M-Mrk/DrumTime/img/DrumTime_1st_sketch.png

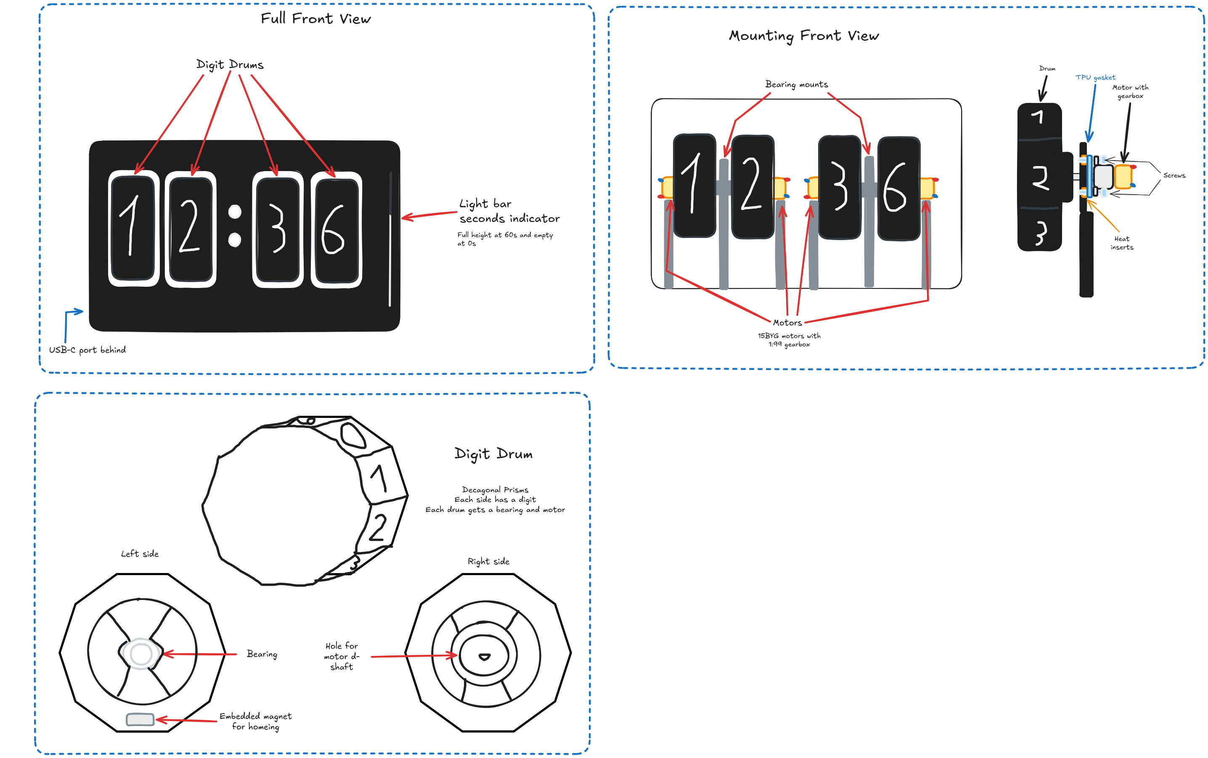
img/DrumTime_1st_sketch.png
