M-Mrk/DrumTime/cad/pcb.step

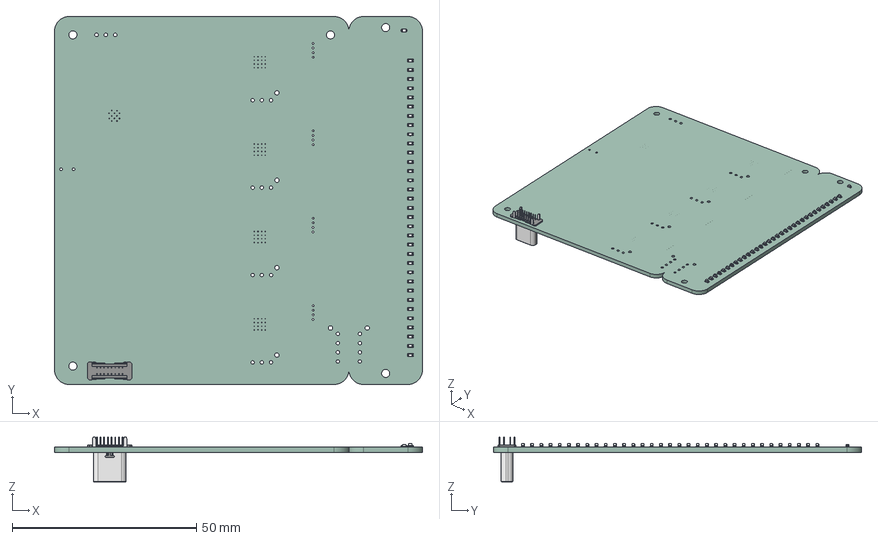
[picture p2: CAD file, 2026-10-08]
cad/pcb.step
100.0 x 100.0 x 12.1 mm
LED0603-R-RD_WHITE x 33
LED-ARRAY-SMD_4P-L1.6-W0.8-BL-FD
零件4
DrumTime_PCB
