M-Mrk/DrumTime/(list of files, drawings)

Other design files:
pcb/temp-freerouting.dsn
