M-Mrk/DrumTime/pcb/DrumTime.kicad_pcb

## KiCad design pcb/DrumTime.kicad_pcb (2026-10-08)

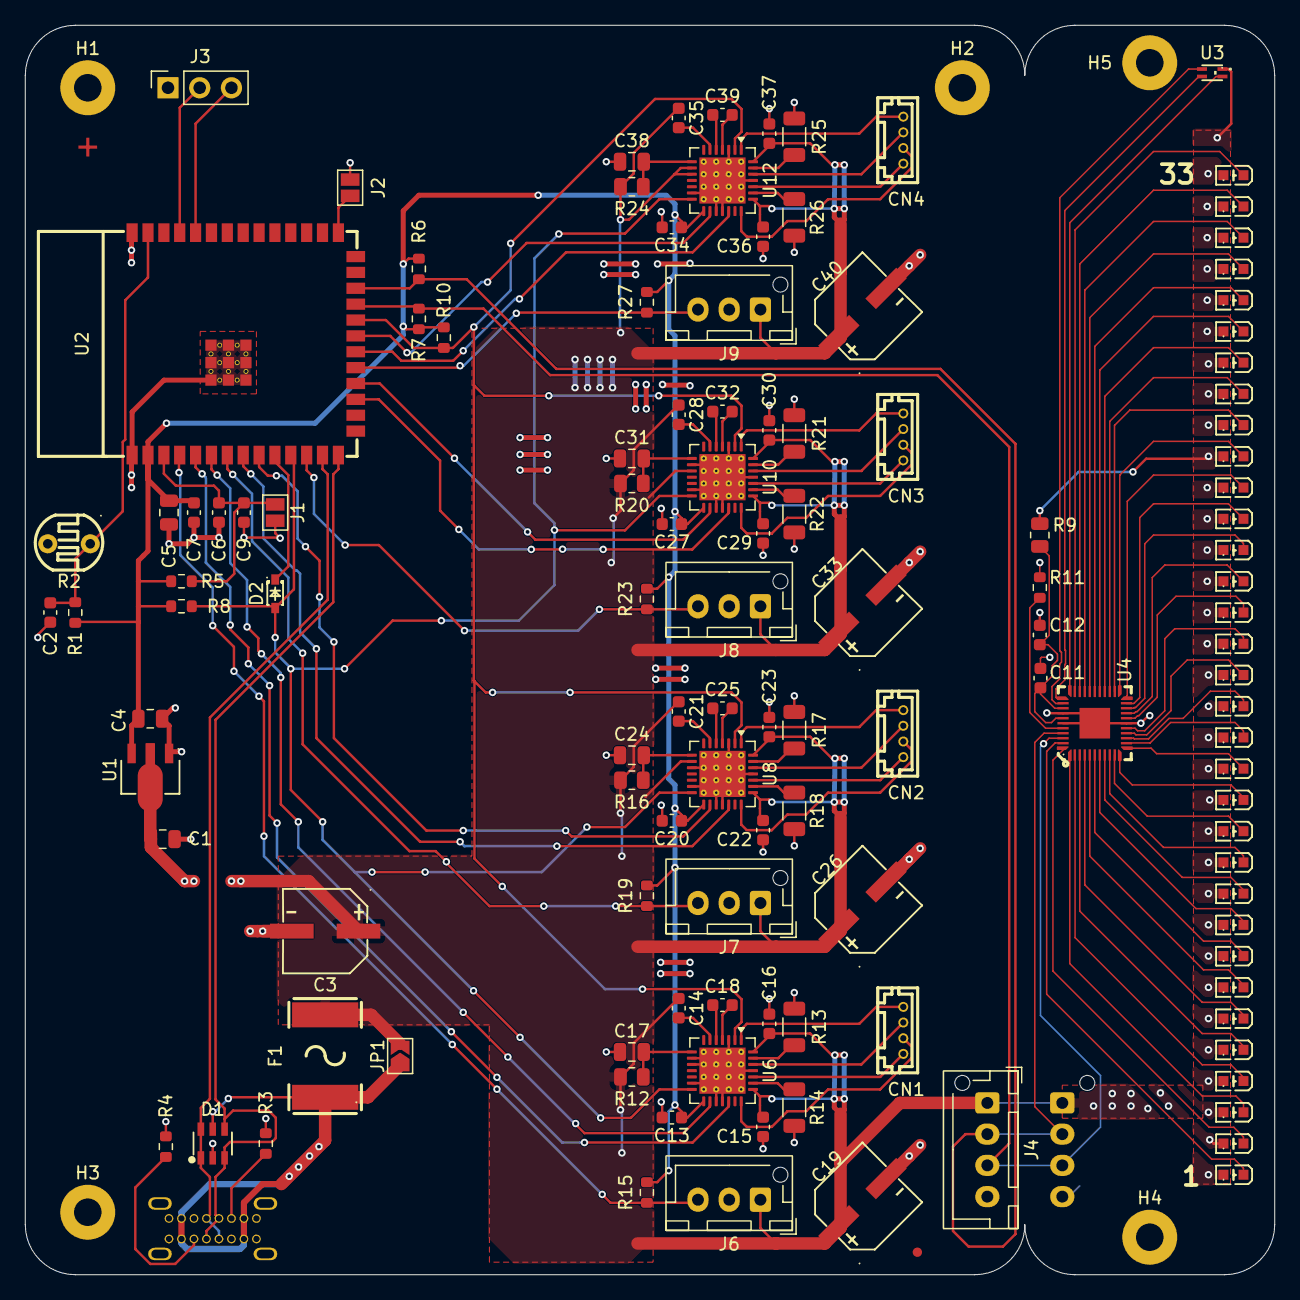
[picture p3: board DrumTime.kicad_pcb from above]

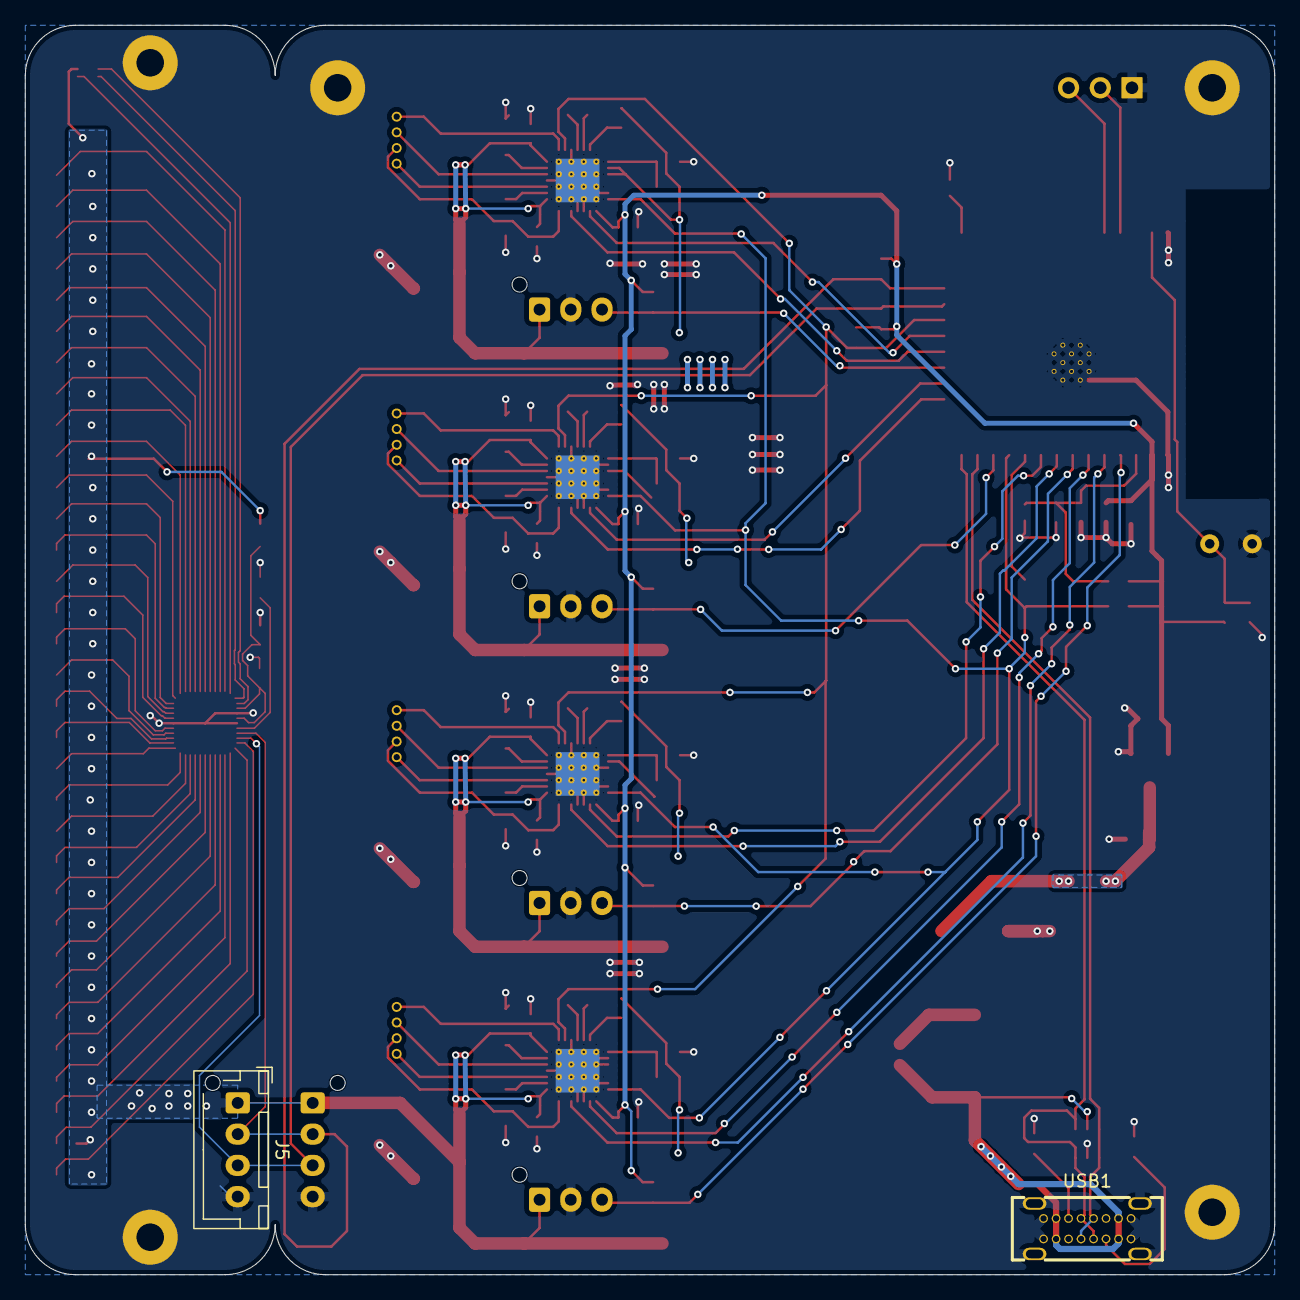
[picture p4: board DrumTime.kicad_pcb from below]

Board: 2 copper layers, 100.0 x 100.0 mm, 131 parts (2 on the bottom side), 108 nets.

Parts:
C1, C4, C17, C24, C31, C38: 10uF; C_0805_2012Metric
C2, C6, C7, C11, C13, C14, C15, C16, C20, C21, C22, C23, C27, C28, C29, C30, C34, C35, C36, C37: 100nF; C_0603_1608Metric
C3, C19, C26, C33, C40: 100uF; CAP-SMD_BD6.3-L6.6-W6.6-FD
C5: 22uF; C_0805_2012Metric
C9, C12: 1uF; C_0603_1608Metric
C18, C25, C32, C39: 22nF; C_0603_1608Metric
CN1, CN2, CN3, CN4: Motor; CONN-TH_530470410
D1: USBLC6-2SC6; SOT-23-6_L2.9-W1.6-P0.95-LS2.8-BL
D2: BAT60B; SOD-323_L1.7-W1.3-LS2.6-RD-1
F1: Polyfuse; F2920
FID1: Fiducial; Fiducial_Cross_1.5mm_Mask2mm
FID2: Fiducial; Fiducial_0.75mm_Mask1.5mm
H1, H2, H3, H4, H5: MountingHole; MountingHole_2.2mm_M2_Pad
J1: EN; SolderJumper-2_P1.3mm_Open_Pad1.0x1.5mm
J2: Boot; SolderJumper-2_P1.3mm_Open_Pad1.0x1.5mm
J3: Debug; PinSocket_1x03_P2.54mm_Vertical
J4, J5: LED_Conn; JST_XH_B4B-XH-AM_1x04_P2.50mm_Vertical
J6, J7, J8, J9: Hall; JST_XH_B3B-XH-AM_1x03_P2.50mm_Vertical
JP1: JMP Fuse; SolderJumper-2_P1.3mm_Open_TrianglePad1.0x1.5mm
LED1, LED2, LED3, LED4, LED5, LED6, LED7, LED8, LED9, LED10, LED11, LED12, LED13, LED14, LED15, LED16, LED17, LED18, LED19, LED20, LED21, LED22, LED23, LED24, LED25, LED26, LED27, LED28, LED29, LED30, LED31, LED32, LED33: LED0603-R-RD_WHITE
R1, R5, R10, R15, R19, R23, R27: 10kR; R_0603_1608Metric
R2: GL5528; RES-TH_L5.1-W4.3-P3.40-D0.5
R3, R4, R6, R7, R8: 5.1kR; R_0603_1608Metric
R9, R12, R16, R20, R24: 10R; R_0805_2012Metric
R11: 15kR; R_0603_1608Metric
R13, R14, R17, R18, R21, R22, R25, R26: 0.33R; R_1206_3216Metric
U1: ME6210A33PG; SOT-89_L4.5-W2.5-P1.50-LS4.2-BR
U2: ESP32-S3-WROOM-1-N8; WIFIM-SMD_ESP32-S3-WROOM-1-N8
U3: TJ-S1608SW6TDSLCCYRGB-A5; LED-ARRAY-SMD_4P-L1.6-W0.8-BL-FD
U4: IS31FL3236A-QFLS2-TR; QFN-44_L5.0-W5.0-P0.40-BL-EP
U6, U8, U10, U12: TMC2209-LA; VQFN-28-1EP_5x5mm_P0.5mm_EP3.7x3.7mm_ThermalVias
USB1: Type-C; USB-C-TH_TYPE-C16PLCH10.0-B143

Connections:
+3V3: C4.1, C5.1, C7.1, C13.1, C20.1, C27.1, C34.1, R1.2, R5.1, R6.1, R7.1, R8.1, R10.1, R15.1, R19.1, R23.1, R27.1, U1.3 (Vout), U2.2 (3V3), U6.15 (VCC_IO), U8.15 (VCC_IO), U10.15 (VCC_IO), U12.15 (VCC_IO)
+5V: C1.1, C3.1, C14.1, C15.1, C16.1, C19.1, C21.1, C22.1, C23.1, C26.1, C28.1, C29.1, C30.1, C33.1, C35.1, C36.1, C37.1, C40.1, F1.2, J4.1, J5.1, J6.1, J7.1, J8.1, J9.1, JP1.2 (B), LED1.1 (A), LED2.1 (A), LED3.1 (A), LED4.1 (A), LED5.1 (A), LED6.1 (A), LED7.1 (A), LED8.1 (A), LED9.1 (A), LED10.1 (A), LED11.1 (A), LED12.1 (A), LED13.1 (A), LED14.1 (A), LED15.1 (A), LED16.1 (A), LED17.1 (A), LED18.1 (A), LED19.1 (A), LED20.1 (A), LED21.1 (A), LED22.1 (A), LED23.1 (A), LED24.1 (A), LED25.1 (A), LED26.1 (A), LED27.1 (A), LED28.1 (A), LED29.1 (A), LED30.1 (A), LED31.1 (A), LED32.1 (A), LED33.1 (A), R9.1, R12.1, R16.1, R20.1, R24.1, U1.2 (Vin), U3.1 (+), U6.22 (VS), U6.28 (VS), U8.9 (MS1/AD0), U8.22 (VS), U8.28 (VS), U10.10 (MS2/AD1), U10.22 (VS), U10.28 (VS), U12.9 (MS1/AD0), U12.10 (MS2/AD1), U12.22 (VS), U12.28 (VS)
/LDR_sense: C2.1, R1.1, R2.1, U2.39 (IO1)
/LEDs/1: LED1.2 (K), U4.43 (OUT1)
/LEDs/2: LED2.2 (K), U4.44 (OUT2)
/LEDs/3: LED3.2 (K), U4.1 (OUT3)
/LEDs/4: LED4.2 (K), U4.2 (OUT4)
/LEDs/5: LED5.2 (K), U4.3 (OUT5)
/LEDs/6: LED6.2 (K), U4.4 (OUT6)
/LEDs/7: LED7.2 (K), U4.5 (OUT7)
/LEDs/8: LED8.2 (K), U4.6 (OUT8)
/LEDs/9: LED9.2 (K), U4.7 (OUT9)
/LEDs/10: LED10.2 (K), U4.8 (OUT10)
/LEDs/11: LED11.2 (K), U4.9 (OUT11)
/LEDs/12: LED12.2 (K), U4.10 (OUT12)
/LEDs/13: LED13.2 (K), U4.11 (OUT13)
/LEDs/14: LED14.2 (K), U4.12 (OUT14)
/LEDs/15: LED15.2 (K), U4.13 (OUT15)
/LEDs/16: LED16.2 (K), U4.14 (OUT16)
/LEDs/17: LED17.2 (K), U4.15 (OUT17)
/LEDs/18: LED18.2 (K), U4.16 (OUT18)
/LEDs/19: LED19.2 (K), U4.18 (OUT19)
/LEDs/20: LED20.2 (K), U4.19 (OUT20)
/LEDs/21: LED21.2 (K), U4.20 (OUT21)
/LEDs/22: LED22.2 (K), U4.21 (OUT22)
/LEDs/23: LED23.2 (K), U4.22 (OUT23)
/LEDs/24: LED24.2 (K), U4.23 (OUT24)
/LEDs/25: LED25.2 (K), U4.24 (OUT25)
/LEDs/26: LED26.2 (K), U4.25 (OUT26)
/LEDs/27: LED27.2 (K), U4.26 (OUT27)
/LEDs/28: LED28.2 (K), U4.27 (OUT28)
/LEDs/29: LED29.2 (K), U4.28 (OUT29)
/LEDs/30: LED30.2 (K), U4.29 (OUT30)
/LEDs/31: LED31.2 (K), U4.30 (OUT31)
/LEDs/32: LED32.2 (K), U4.31 (OUT32)
/LEDs/33: LED33.2 (K), U4.32 (OUT33)
/Motor1/A+: CN2.1, U8.24 (OA1)
/Motor1/A-: CN2.2, U8.21 (OA2)
/Motor1/B+: CN2.3, U8.26 (OB1)
/Motor1/B-: CN2.4, U8.1 (OB2)
/Motor2/A+: CN3.1, U10.24 (OA1)
/Motor2/A-: CN3.2, U10.21 (OA2)
/Motor2/B+: CN3.3, U10.26 (OB1)
/Motor2/B-: CN3.4, U10.1 (OB2)
/Motor3/A+: CN4.1, U12.24 (OA1)
/Motor3/A-: CN4.2, U12.21 (OA2)
/Motor3/B+: CN4.3, U12.26 (OB1)
/Motor3/B-: CN4.4, U12.1 (OB2)
/Motor/A+: CN1.1, U6.24 (OA1)
/Motor/A-: CN1.2, U6.21 (OA2)
/Motor/B+: CN1.3, U6.26 (OB1)
/Motor/B-: CN1.4, U6.1 (OB2)
/RGB_B: U3.2 (-), U4.35 (OUT36)
/RGB_G: U3.3 (-), U4.34 (OUT35)
/RGB_R: U3.4 (-), U4.33 (OUT34)
/SCL: J4.3, J5.3, R7.2, U2.23 (IO21), U4.42 (SCL)
/SDA: J4.2, J5.2, R6.2, U2.24 (IO47), U4.41 (SDA)
/SDB: C11.1, C12.1, R9.2, U4.36 (SDB), U4.38 (VCC)
/USB_D+: D1.3, D1.4, U2.14 (IO20), USB1.A6 (DP1), USB1.B6 (DP2)
/USB_D-: D1.1, D1.6, U2.13 (IO19), USB1.A7 (DN1), USB1.B7 (DN2)
/cc1: R3.1, USB1.A5 (CC1)
/cc2: R4.1, USB1.B5 (CC2)
/m0_dir: U2.5 (IO5), U6.19 (DIR)
/m0_hall: J6.3, R15.2, U2.4 (IO4)
/m0_step: U2.6 (IO6), U6.16 (STEP)
/m1_dir: U2.8 (IO15), U8.19 (DIR)
/m1_hall: J7.3, R19.2, U2.7 (IO7)
/m1_step: U2.9 (IO16), U8.16 (STEP)
/m2_dir: U2.17 (IO9), U10.19 (DIR)
/m2_hall: J8.3, R23.2, U2.12 (IO8)
/m2_step: U2.18 (IO10), U10.16 (STEP)
/m3_dir: U2.20 (IO12), U12.19 (DIR)
/m3_hall: J9.3, R27.2, U2.19 (IO11)
/m3_step: U2.21 (IO13), U12.16 (STEP)
/m_enn: R10.2, U2.22 (IO14), U6.2 (~EN), U8.2 (~EN), U10.2 (~EN), U12.2 (~EN)
/m_uart: D2.2 (A), R8.2, U2.11 (IO18), U6.14 (~PD/UART), U8.14 (~PD/UART), U10.14 (~PD/UART), U12.14 (~PD/UART)
/uart1_tx: D2.1 (K), U2.10 (IO17)
GND: C1.2, C2.2, C3.2, C4.2, C5.2, C6.2, C7.2, C9.2, C11.2, C12.2, C13.2, C15.2, C16.2, C17.1, C19.2, C20.2, C22.2, C23.2, C24.1, C26.2, C27.2, C29.2, C30.2, C31.1, C33.2, C34.2, C36.2, C37.2, C38.1, C40.2, D1.2, H1.1 (1_1), H2.1 (1_1), H3.1 (1_1), H4.1 (1_1), H5.1 (1_1), J1.2, J2.2, J3.1, J4.4, J5.4, J6.2, J7.2, J8.2, J9.2, R2.2, R3.2, R4.2, R11.2, R13.2, R14.2, R17.2, R18.2, R21.2, R22.2, R25.2, R26.2, U1.1 (Vss), U2.1 (GND), U2.40 (GND), U2.41 (EP), U4.17 (GND), U4.37 (AD), U4.39 (GND), U4.45 (EPAD), U6.3 (GND), U6.9 (MS1/AD0), U6.10 (MS2/AD1), U6.13 (CLK), U6.17 (VREF), U6.18 (GND), U6.25 (NC), U6.29 (GND), U8.3 (GND), U8.10 (MS2/AD1), U8.13 (CLK), U8.17 (VREF), U8.18 (GND), U8.25 (NC), U8.29 (GND), U10.3 (GND), U10.9 (MS1/AD0), U10.13 (CLK), U10.17 (VREF), U10.18 (GND), U10.25 (NC), U10.29 (GND), U12.3 (GND), U12.13 (CLK), U12.17 (VREF), U12.18 (GND), U12.25 (NC), U12.29 (GND), USB1.0 (EH), USB1.A1 (GND), USB1.A12 (GND), USB1.B1 (GND), USB1.B12 (GND)
unnamed: C6.1, C9.1, J1.1, R5.2, U2.3 (EN)
unnamed: J2.1, U2.27 (IO0)
unnamed: J3.2, U2.37 (TXD0)
unnamed: J3.3, U2.36 (RXD0)
unnamed: R11.1, U4.40 (R-EXT)
unnamed: C17.2, R12.2, U6.8 (5VOUT)
unnamed: R14.1, U6.23 (BRA)
unnamed: R13.1, U6.27 (BRB)
unnamed: C18.2, U6.5 (CPI)
unnamed: C18.1, U6.4 (CPO)
unnamed: C14.2, U6.6 (VCP)
unnamed: C24.2, R16.2, U8.8 (5VOUT)
unnamed: R18.1, U8.23 (BRA)
unnamed: R17.1, U8.27 (BRB)
unnamed: C25.2, U8.5 (CPI)
unnamed: C25.1, U8.4 (CPO)
unnamed: C21.2, U8.6 (VCP)
unnamed: C31.2, R20.2, U10.8 (5VOUT)
unnamed: R22.1, U10.23 (BRA)
unnamed: R21.1, U10.27 (BRB)
unnamed: C32.2, U10.5 (CPI)
unnamed: C32.1, U10.4 (CPO)
unnamed: C28.2, U10.6 (VCP)
unnamed: C38.2, R24.2, U12.8 (5VOUT)
unnamed: R26.1, U12.23 (BRA)
unnamed: R25.1, U12.27 (BRB)
unnamed: C39.2, U12.5 (CPI)
unnamed: C39.1, U12.4 (CPO)
unnamed: C35.2, U12.6 (VCP)
VBUS: D1.5, F1.1, JP1.1 (A), USB1.A4 (VBUS), USB1.A9 (VBUS), USB1.B4 (VBUS), USB1.B9 (VBUS)
