M-Mrk/DrumTime/(commit log)

2026-09-22 feat(pcb/motors): add connections for the motors with hall effect sensors. (R_sense unspecified)
    [DrumTime.kicad_sch, motor.kicad_sch, motors.kicad_sch]
2026-09-23 feat(pcb/mcu): add ldo for 3v3 power and add needed passives and circuitry for MCU
    [DrumTime.kicad_sch]
2026-09-24 feat(pcb/leds): add seconds indicator light bar and misc rgb indicator
    [DrumTime.kicad_sch, leds.kicad_sch, motor.kicad_sch]
2026-09-24 chore(pcb): delete unused motors file
    [motors.kicad_sch]
2026-09-26 feat(pcb/leds): add LDR
    [DrumTime.kicad_sch]
2026-09-28 feat(pcb): remove levelshifters, change to 3v3 vcc_io on tmc2209s, add rgb led to led driver, add R_ext value for led driver, add R_sense value for tmc2209s, add seperate dir signals for each tmc2209
    [DrumTime.kicad_sch, leds.kicad_sch, motor.kicad_sch]
2026-09-29 feat(pcb): add a central ENN connection to all motor drivers, switch LDO to one with higher input voltage tolerances and add PTC fuse
    [DrumTime.kicad_sch, motor.kicad_sch]
2026-10-01 feat(pcb): source all parts, switch to straight tht usb to mount on back and add series resistor LED driver to prevent over voltage
    [DrumTime.kicad_sch, leds.kicad_sch, motor.kicad_sch]
2026-10-03 feat(pcb): layout and route LED section
    [DrumTime.kicad_pcb, DrumTime.kicad_sch, leds.kicad_sch, motor.kicad_sch]
2026-10-03 feat(pcb): layout motor drivers and route internally
    [DrumTime.kicad_pcb, DrumTime.kicad_sch, leds.kicad_sch, motor.kicad_sch]
2026-10-03 feat(pcb): finish initial routing and layouting
    [DrumTime.kicad_pcb, DrumTime.kicad_sch, bom.csv, designators.csv, positions.csv, temp-freerouting.dsn]
2026-10-04 chore(pcb): remove production folder from git tracking
    [bom.csv, designators.csv, positions.csv]
2026-10-08 feat(firmware): setup firmware environment for esp-idf
    [DrumTime.kicad_pcb, pcb.step]
2026-10-13 feat(firmware/leds): add wrappers to all functions of the LED driver IC
2026-10-13 feat(pcb/firmware): complete leds component
2026-10-17 feat(pcb/firmware): create tmc_bus component
2026-10-20 feat(firmware/tmc): implement turning motor functions
2026-10-22 feat(firmware/motor_controller): add motor controller
